KacperKub/Robot_empatyczny/Piny.txt

PC0  - Czujnik prądu 		- silnik B
PC1  - Czujnik prądu 		- silnik A

PC5  - Czujnik odległości 1     - XShut
PC13 - Czujnik odległości 2 	- XShut
PB2  - Czujnik odległości 3	- XShut
PB8  - Czujnik odległości 1-3   - VL_IRQ

PA0  - Enkoder silnika 2	- Port A ( wyjście Halla 1 )
PA1  - Enkoder silnika 2 	- Port B ( wyjście Halla 2 )
PB6  - Enkoder silnika 1	- Port A ( wyjście Halla 1 )
PB7  - Enkoder silnika 1 	- Port B ( wyjście Halla 2 )

PA6  - Mostek H			- AIN 1 
PA7  - Mostek H			- AIN 2
PB0  - Mostek H 		- BIN 2
PB1  - Mostek H			- BIN 1
PB14 - Mostek H      		- nSleep
PB13 - Mostek H			- nFault ( "1" to dobrze )

PA8  - Nucleo 			- SCL
PC9  - Nucleo			- SDA
PA9  - Nucleo 			- UART_TX
PA10 - Nucleo 			- UART_RX
