KacperKub/Robot_empatyczny/Pin_config.png

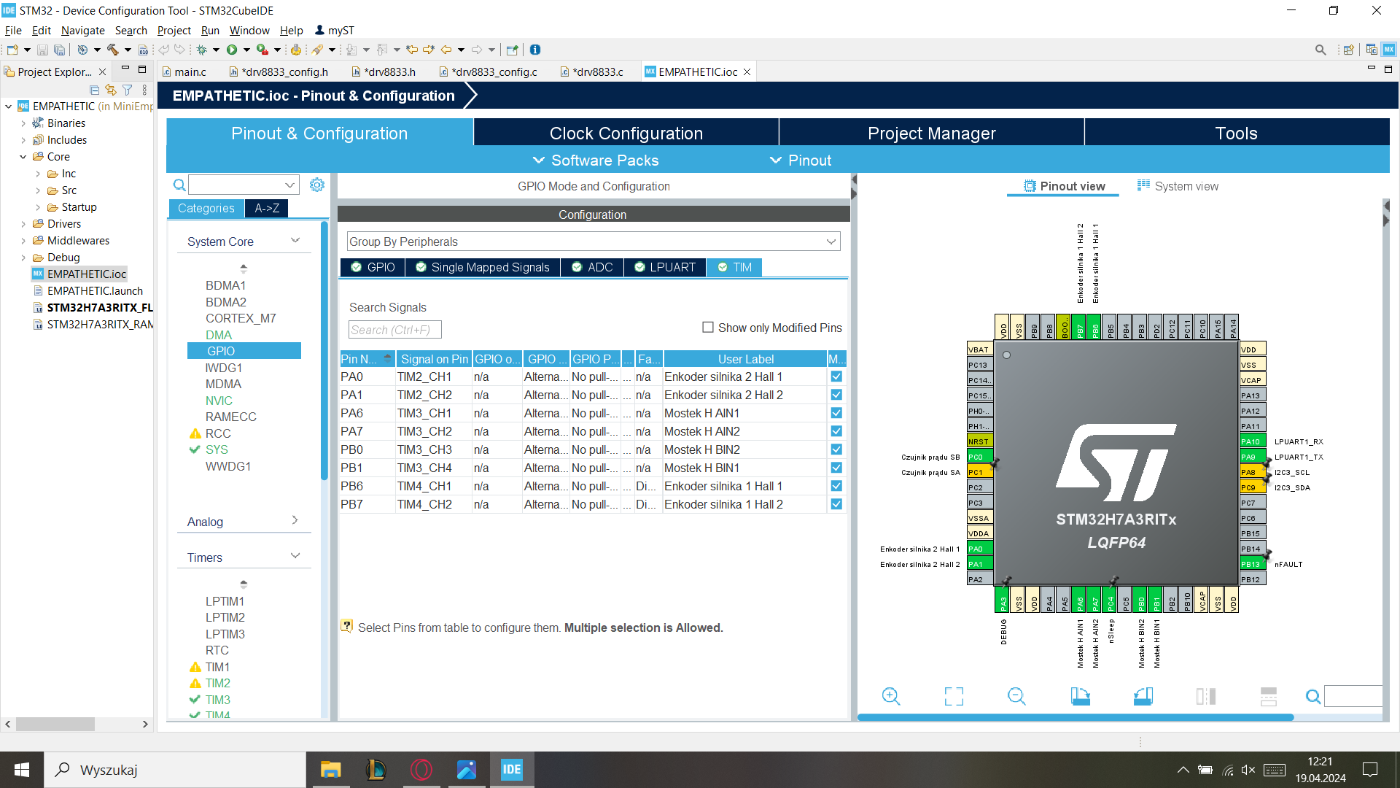
Pin_config.png
