KacperKub/Robot_empatyczny/Github_RobotUAM/kicad_workspace/3d_models/tp5100.step

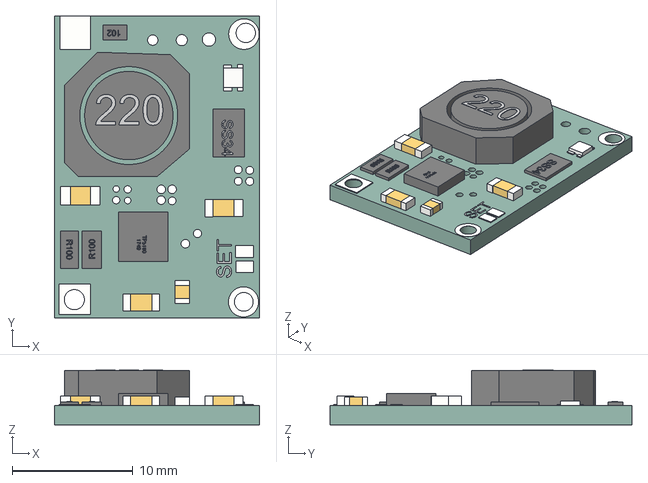
[picture p5: CAD file, 2024-04-26]
Github_RobotUAM/kicad_workspace/3d_models/tp5100.step
17.0 x 25.0 x 4.54 mm
