KacperKub/Robot_empatyczny/Github_RobotUAM/kicad_workspace/3d_models/pololu-ball-caster-with-0-375in-ball.step

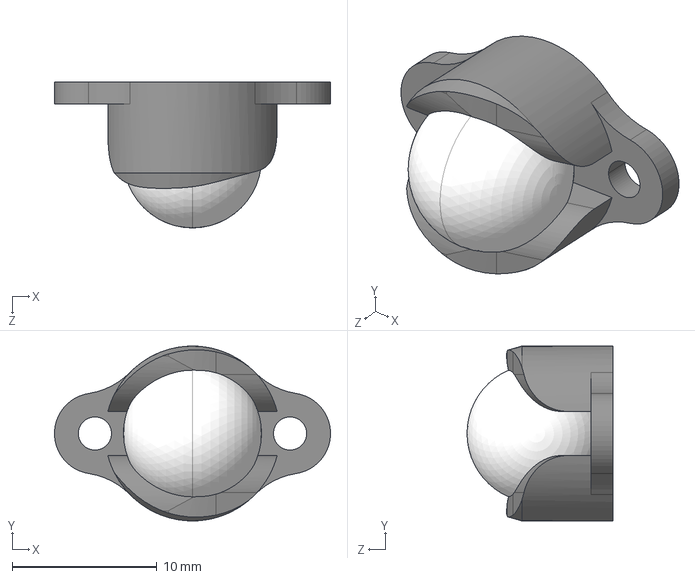
[picture p6: CAD file, 2024-04-26]
Github_RobotUAM/kicad_workspace/3d_models/pololu-ball-caster-with-0-375in-ball.step
19.0 x 12.1 x 10.1 mm
