KacperKub/Robot_empatyczny/Github_RobotUAM/kicad_workspace/3d_models/pololu-wheel-32x7mm-black.step

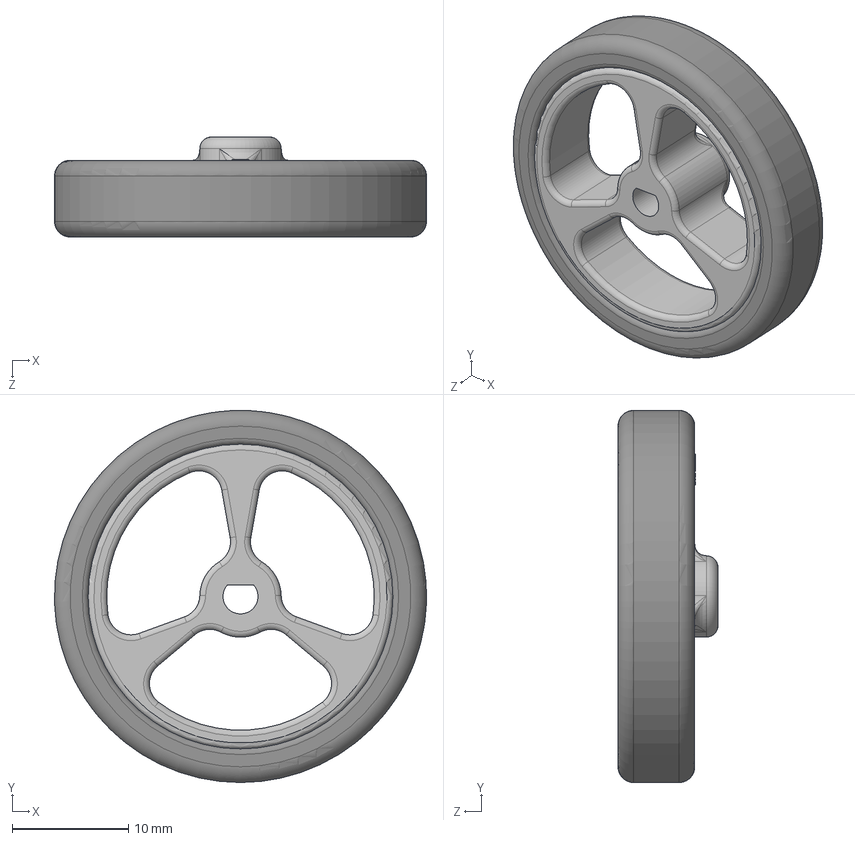
[picture p7: CAD file, 2024-04-26]
Github_RobotUAM/kicad_workspace/3d_models/pololu-wheel-32x7mm-black.step
32.0 x 32.0 x 8.60 mm
