KacperKub/Robot_empatyczny/Github_RobotUAM/kicad_workspace/3d_models/magnetic-encoder-pair-kit-for-micro-metal-gearmotors-hpcb-compatible-w1r02a.step

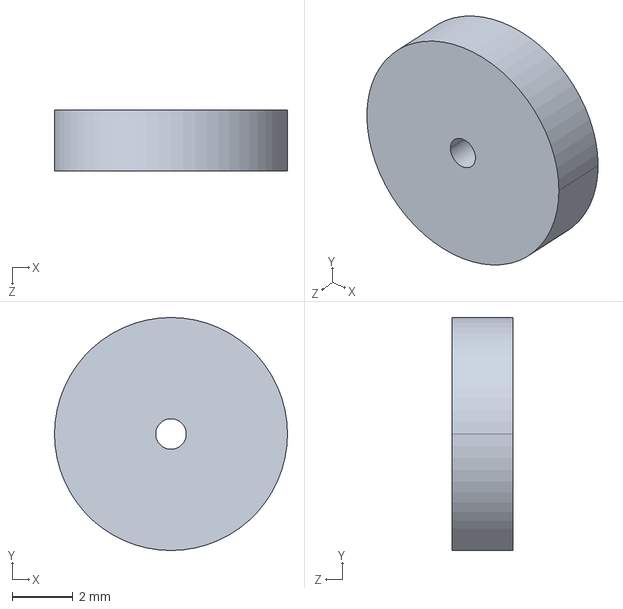
[picture p8: CAD file, 2024-04-26]
Github_RobotUAM/kicad_workspace/3d_models/magnetic-encoder-pair-kit-for-micro-metal-gearmotors-hpcb-compatible-w1r02a.step
7.65 x 7.65 x 2.00 mm
