KacperKub/Robot_empatyczny/Github_RobotUAM/kicad_workspace/3d_models/vl53l0x.stp

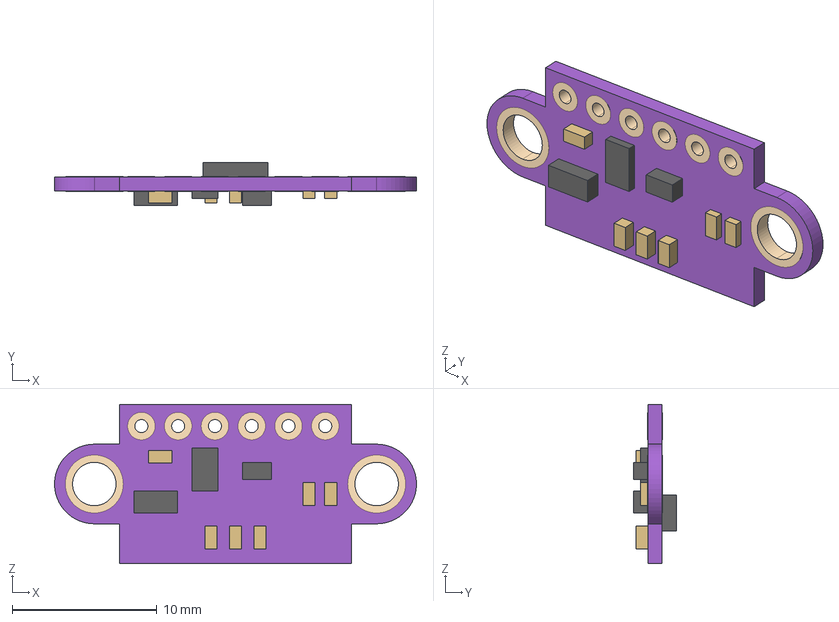
[picture p9: CAD file, 2024-04-26]
Github_RobotUAM/kicad_workspace/3d_models/vl53l0x.stp
25.0 x 3.00 x 11.0 mm
