KacperKub/Robot_empatyczny/Github_RobotUAM/kicad_workspace/3d_models/ultrasound.step

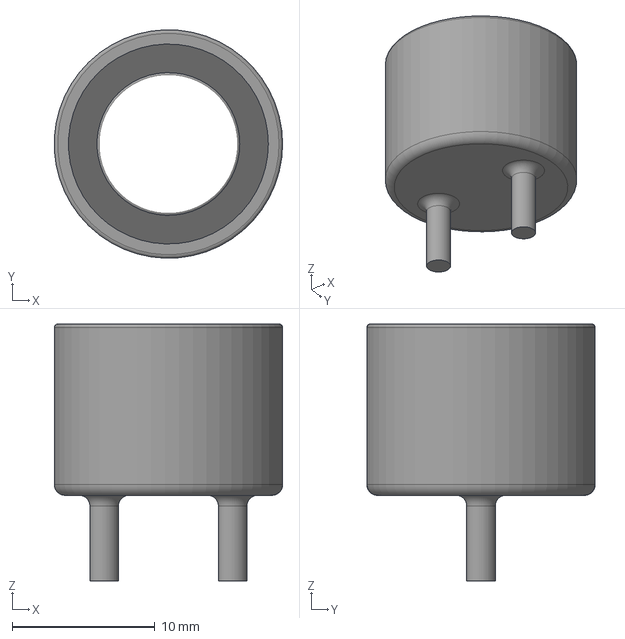
[picture p10: CAD file, 2024-04-26]
Github_RobotUAM/kicad_workspace/3d_models/ultrasound.step
16.0 x 16.0 x 18.0 mm
