KacperKub/Robot_empatyczny/Github_RobotUAM/kicad_workspace/3d_models/pololu-step-up-step-down-voltage-regulator-s7v8fx.step

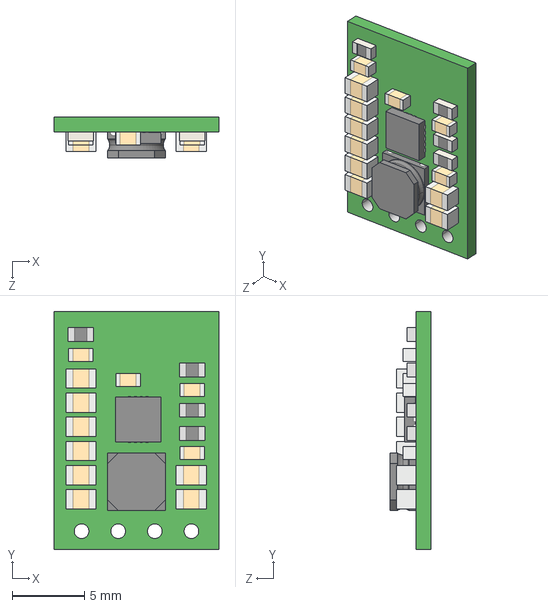
[picture p11: CAD file, 2024-04-26]
Github_RobotUAM/kicad_workspace/3d_models/pololu-step-up-step-down-voltage-regulator-s7v8fx.step
11.4 x 16.5 x 2.82 mm
