KacperKub/Robot_empatyczny/Github_RobotUAM/kicad_workspace/3d_models/magnetic-encoder-pair-kit-for-micro-metal-gearmotors-hpcb-compatible-enc03b.step

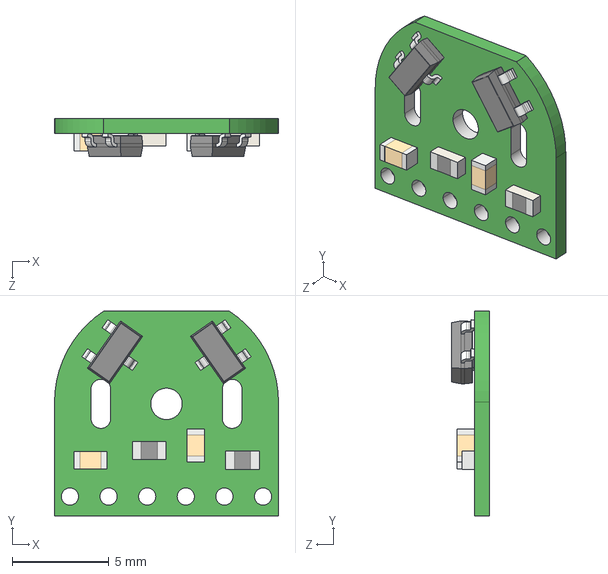
[picture p12: CAD file, 2024-04-26]
Github_RobotUAM/kicad_workspace/3d_models/magnetic-encoder-pair-kit-for-micro-metal-gearmotors-hpcb-compatible-enc03b.step
11.6 x 10.6 x 1.99 mm
