KacperKub/Robot_empatyczny/Github_RobotUAM/kicad_workspace/3d_models/ark_conn.step

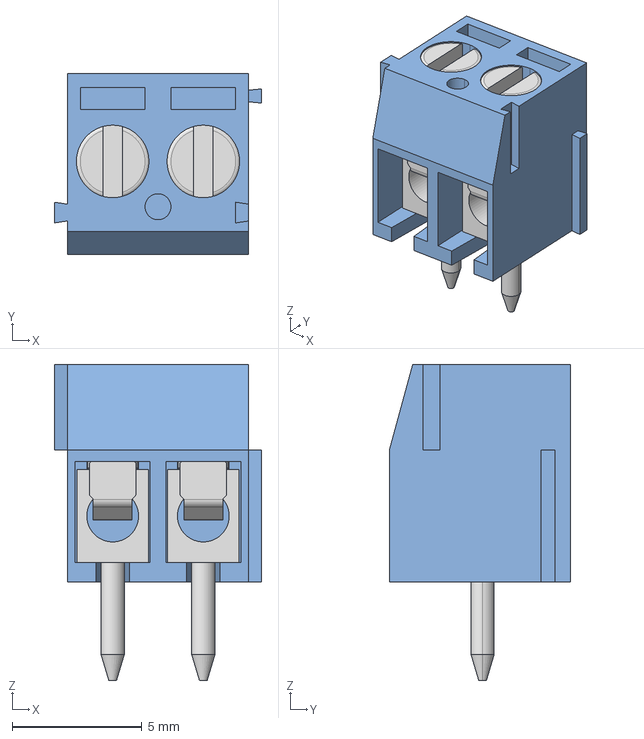
[picture p13: CAD file, 2024-04-26]
Github_RobotUAM/kicad_workspace/3d_models/ark_conn.step
8.00 x 7.00 x 12.2 mm
