KacperKub/Robot_empatyczny/Github_RobotUAM/kicad_workspace/3d_models/BQ24250RGER.stp

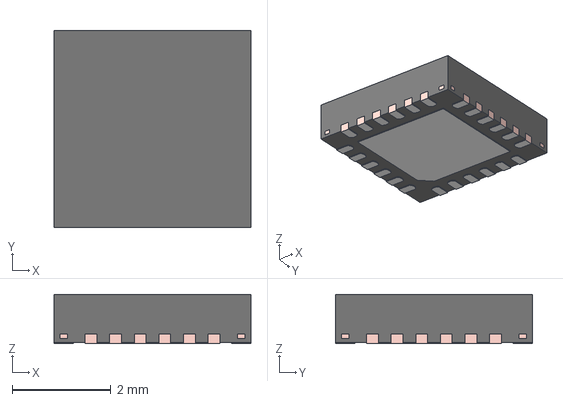
[picture p14: CAD file, 2024-04-26]
Github_RobotUAM/kicad_workspace/3d_models/BQ24250RGER.stp
4.00 x 4.00 x 1.00 mm
FRAME
