KacperKub/Robot_empatyczny/Github_RobotUAM/kicad_workspace/3d_models/INR18650-35E-Samsung.STEP

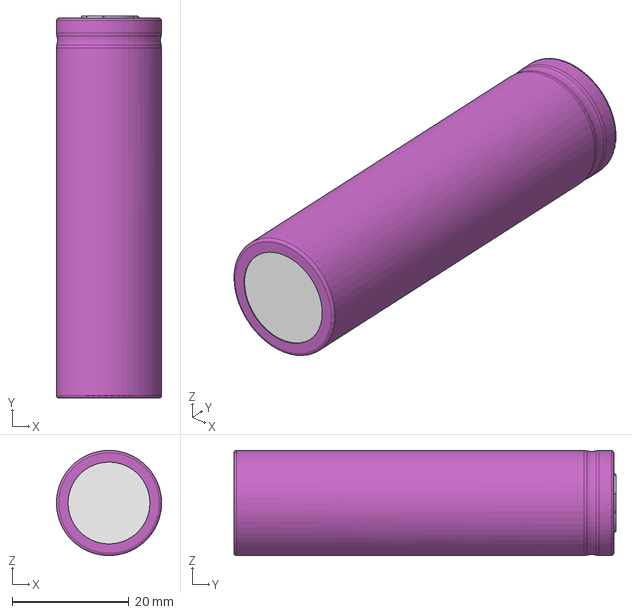
[picture p15: CAD file, 2024-04-26]
Github_RobotUAM/kicad_workspace/3d_models/INR18650-35E-Samsung.STEP
18.0 x 65.4 x 18.0 mm
