KacperKub/Robot_empatyczny/(list of files, cad)

Other CAD files:
Github_RobotUAM/kicad_workspace/bottom/pcb_shape/shape.FCStd
Github_RobotUAM/kicad_workspace/bottom/pcb_shape/shape_with_mount_holes.FCStd
Github_RobotUAM/kicad_workspace/bottom/pcb_shape/shape.dxf
