KacperKub/Robot_empatyczny/Github_RobotUAM/kicad_workspace/bottom/bottom.kicad_pcb

## KiCad design Github_RobotUAM/kicad_workspace/bottom/bottom.kicad_pcb (2024-04-26)

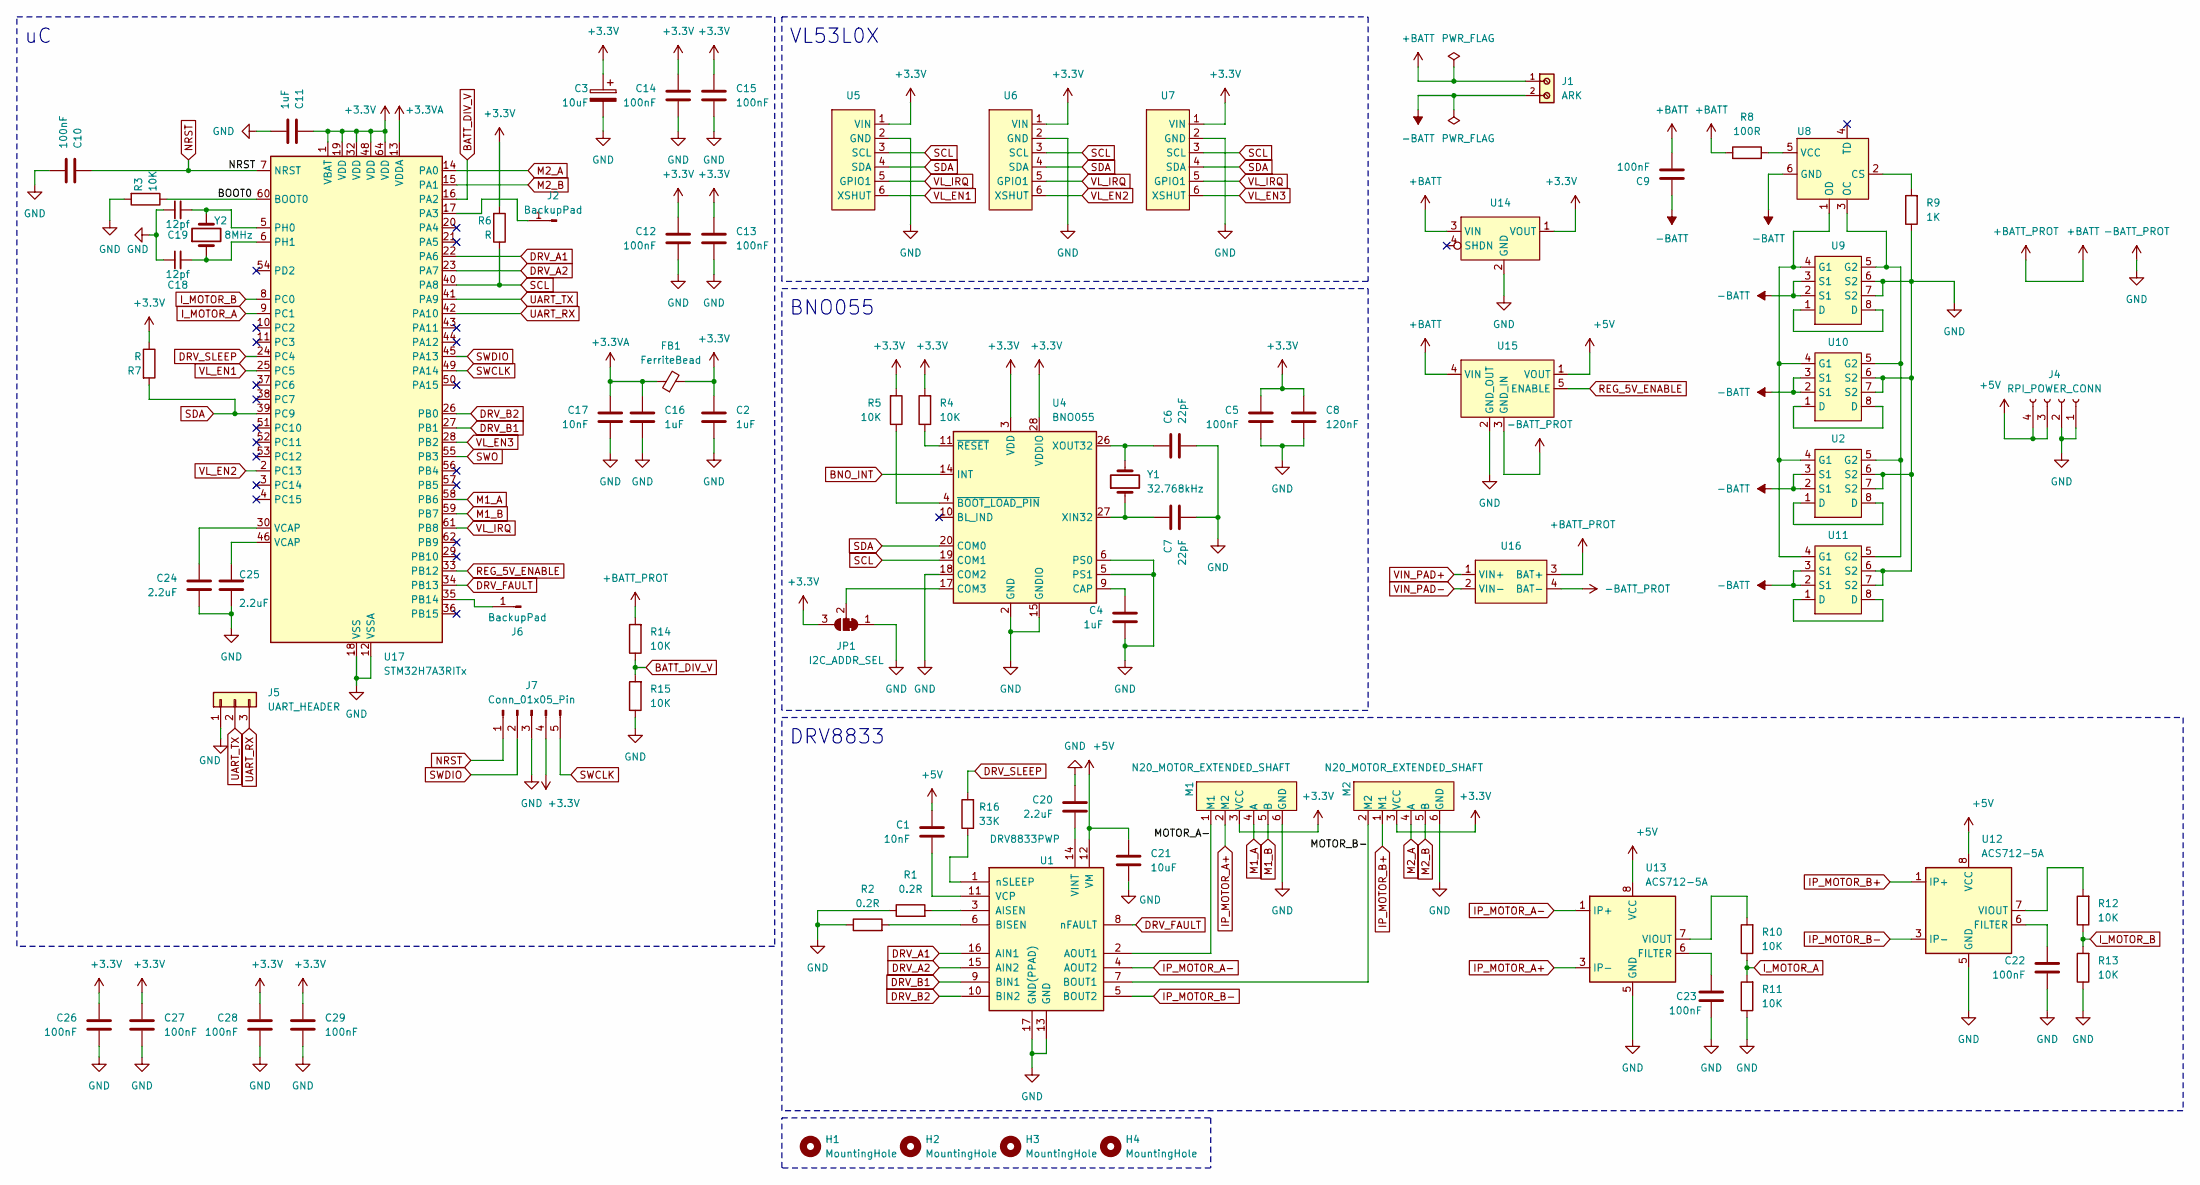
[picture p16: schematic bottom.kicad_sch]

Parts:
C1, C17: 10nF; C_0805_2012Metric
C2, C4, C11, C16: 1uF; C_0805_2012Metric
C3: 10uF; CP_Elec_4x3
C5, C9, C10, C12, C13, C14, C15, C22, C23, C26, C27, C28, C29: 100nF; C_0805_2012Metric
C6, C7: 22pF; C_0805_2012Metric
C8: 120nF; C_0805_2012Metric
C18, C19: 12pf; C_0805_2012Metric
C20, C24, C25: 2.2uF; C_0805_2012Metric
C21: 10uF; C_0805_2012Metric
FB1: FerriteBead; L_0805_2012Metric
H1, H2, H3, H4: MountingHole
J1: ARK; 691103110002; PART-NUMBER 691103110002
J2, J6: BackupPad; SolderWirePad_1x01_SMD_1x2mm
J4: RPI_POWER_CONN; JST_XH_B4B-XH-A_1x04_P2.50mm_Vertical
J5: UART_HEADER; PinHeader_1x03_P2.54mm_Vertical
J7: Conn_01x05_Pin; Harwin_M20-89005xx_1x05_P2.54mm_Horizontal
JP1: I2C_ADDR_SEL; SolderJumper-3_P1.3mm_Bridged12_Pad1.0x1.5mm_NumberLabels
M1, M2: N20_MOTOR_EXTENDED_SHAFT; N20_EXTENDED_SHAFT
R1, R2: 0.2R; R_0805_2012Metric
R3, R4, R5, R10, R11, R12, R13, R14, R15: 10K; R_0805_2012Metric
R6, R7: R; R_0805_2012Metric
R8: 100R; R_0805_2012Metric
R9: 1K; R_0805_2012Metric
R16: 33K; R_0805_2012Metric
U1: DRV8833PWP; TSSOP-16-1EP_4.4x5mm_P0.65mm_EP3x3mm_ThermalVias
U2, U9, U10, U11: TSSOP-8_4.4x3mm_P0.65mm
U4: BNO055; LGA-28_5.2x3.8mm_P0.5mm
U5, U6, U7: VL53L0X
U8: SOT-23-6
U12, U13: ACS712-5A; SOIC-8_3.9x4.9mm_P1.27mm
U14: S7V8F3_vertical
U15: U3V70F5
U16: TP5100
U17: STM32H7A3RITx; LQFP-64_10x10mm_P0.5mm
Y1: 32.768kHz; Crystal_SMD_MicroCrystal_CM9V-T1A-2Pin_1.6x1.0mm
Y2: 8MHz; Crystal_SMD_MicroCrystal_CM9V-T1A-2Pin_1.6x1.0mm

Connections:
+3.3V: C2.1, C3.1, C5.1, C8.1, C11.1, C12.1, C13.1, C14.1, C15.1, C26.1, C27.1, C28.1, C29.1, FB1.2, J7.4, JP1.3 (B), M1.3 (VCC), M2.3 (VCC), R4.2, R5.2, R6.2, R7.1, U4.3 (VDD), U4.28 (VDDIO), U5.1 (VIN), U6.1 (VIN), U7.1 (VIN), U14.1 (VOUT), U17.1 (VBAT), U17.19 (VDD), U17.32 (VDD), U17.48 (VDD), U17.64 (VDD)
+3.3VA: C16.1, C17.1, FB1.1, U17.13 (VDDA)
+5V: C1.1, C21.1, J4.3, J4.4, U1.12 (VM), U12.8 (VCC), U13.8 (VCC), U15.1 (VOUT)
+BATT: C9.2, J1.1, R8.1, R14.2, U14.3 (VIN), U15.4 (VIN), U16.3 (BAT+)
-BATT: C9.1, J1.2, U2.2 (S1), U2.3 (S1), U8.6 (GND), U9.2 (S1), U9.3 (S1), U10.2 (S1), U10.3 (S1), U11.2 (S1), U11.3 (S1)
-BATT_PROT: C2.2, C3.2, C4.2, C5.2, C6.2, C7.2, C8.2, C10.2, C11.2, C12.2, C13.2, C14.2, C15.2, C16.2, C17.2, C18.1, C19.1, C20.1, C21.2, C22.2, C23.2, C24.2, C25.2, C26.2, C27.2, C28.2, C29.2, J4.1, J4.2, J5.1, J7.3, JP1.1 (A), M1.6 (GND), M2.6 (GND), R1.1, R2.1, R3.2, R9.1, R11.1, R13.1, R15.1, U1.13 (GND), U1.17 (GND(PPAD)), U2.6 (S2), U2.7 (S2), U4.2 (GND), U4.5 (PS1), U4.6 (PS0), U4.15 (GNDIO), U4.16 (GNDIO), U4.18 (COM2), U4.25 (GNDIO), U5.2 (GND), U6.2 (GND), U7.2 (GND), U9.6 (S2), U9.7 (S2), U10.6 (S2), U10.7 (S2), U11.6 (S2), U11.7 (S2), U12.5 (GND), U13.5 (GND), U14.2 (GND), U15.2 (GND_OUT), U15.3 (GND_IN), U16.4 (BAT-), U17.12 (VSSA), U17.18 (VSS), U17.31 (VSS), U17.47 (VSS), U17.63 (VSS)
/BOOT0: R3.1, U17.60 (BOOT0)
/MOTOR_A-: M1.1 (M1), U1.2 (AOUT1)
BATT_DIV_V: R14.1, R15.2, U17.16 (PA2)
BNO_INT: U4.14 (INT)
DRV_A1: U1.16 (AIN1), U17.22 (PA6)
DRV_A2: U1.15 (AIN2), U17.23 (PA7)
DRV_B1: U1.9 (BIN1), U17.27 (PB1)
DRV_B2: U1.10 (BIN2), U17.26 (PB0)
DRV_FAULT: U1.8 (nFAULT), U17.34 (PB13)
DRV_SLEEP: R16.2, U17.24 (PC4)
IP_MOTOR_A+: M1.2 (M2), U13.3 (IP-), U13.4 (IP-)
IP_MOTOR_A-: U1.4 (AOUT2), U13.1 (IP+), U13.2 (IP+)
IP_MOTOR_B-: U1.5 (BOUT2), U12.3 (IP-), U12.4 (IP-)
I_MOTOR_A: R10.1, R11.2, U17.9 (PC1)
I_MOTOR_B: R12.1, R13.2, U17.8 (PC0)
M1_A: M1.4 (A), U17.58 (PB6)
M1_B: M1.5 (B), U17.59 (PB7)
M2_A: M2.4 (A), U17.14 (PA0)
M2_B: M2.5 (B), U17.15 (PA1)
NRST: C10.1, J7.1, U17.7 (NRST)
unnamed: C24.1, U17.30 (VCAP)
unnamed: C25.1, U17.46 (VCAP)
unnamed: J2.1, U17.17 (PA3)
unnamed: J6.1, U17.35 (PB14)
unnamed: JP1.2 (C), U4.17 (COM3)
unnamed: R1.2, U1.3 (AISEN)
unnamed: R2.2, U1.6 (BISEN)
unnamed: C1.2, U1.11 (VCP)
unnamed: C20.2, U1.14 (VINT)
unnamed: R16.1, U1.1 (nSLEEP)
unnamed: U2.1 (D), U2.8 (D)
unnamed: C4.1, U4.9 (CAP)
unnamed: C7.1, U4.27 (XIN32), Y1.1
unnamed: C6.1, U4.26 (XOUT32), Y1.2
unnamed: R5.1, U4.4 (~BOOT_LOAD_PIN)
unnamed: R4.1, U4.11 (~RESET)
unnamed: R9.2, U8.2 (CS)
unnamed: R8.2, U8.5 (VCC)
unnamed: U9.1 (D), U9.8 (D)
unnamed: U10.1 (D), U10.8 (D)
unnamed: U2.4 (G1), U8.1 (OD), U9.4 (G1), U10.4 (G1), U11.4 (G1)
unnamed: U2.5 (G2), U8.3 (OC), U9.5 (G2), U10.5 (G2), U11.5 (G2)
unnamed: U11.1 (D), U11.8 (D)
unnamed: C22.1, U12.6 (FILTER)
unnamed: R12.2, U12.7 (VIOUT)
unnamed: C23.1, U13.6 (FILTER)
unnamed: R10.2, U13.7 (VIOUT)
unnamed: C19.2, U17.5 (PH0), Y2.2
unnamed: C18.2, U17.6 (PH1), Y2.1
REG_5V_ENABLE: U15.5 (ENABLE), U17.33 (PB12)
SCL: R6.1, U4.19 (COM1), U5.3 (SCL), U6.3 (SCL), U7.3 (SCL), U17.40 (PA8)
SDA: R7.2, U4.20 (COM0), U5.4 (SDA), U6.4 (SDA), U7.4 (SDA), U17.39 (PC9)
SWCLK: J7.5, U17.49 (PA14)
SWDIO: J7.2, U17.45 (PA13)
SWO: U17.55 (PB3)
UART_RX: J5.3, U17.42 (PA10)
UART_TX: J5.2, U17.41 (PA9)
VIN_PAD+: U16.1 (VIN+)
VIN_PAD-: U16.2 (VIN-)
VL_EN1: U5.6 (XSHUT), U17.25 (PC5)
VL_EN2: U6.6 (XSHUT), U17.2 (PC13)
VL_EN3: U7.6 (XSHUT), U17.28 (PB2)
VL_IRQ: U5.5 (GPIO1), U6.5 (GPIO1), U7.5 (GPIO1), U17.61 (PB8)

Notes on the sheet:
DRV8833
VL53L0X
BNO055

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
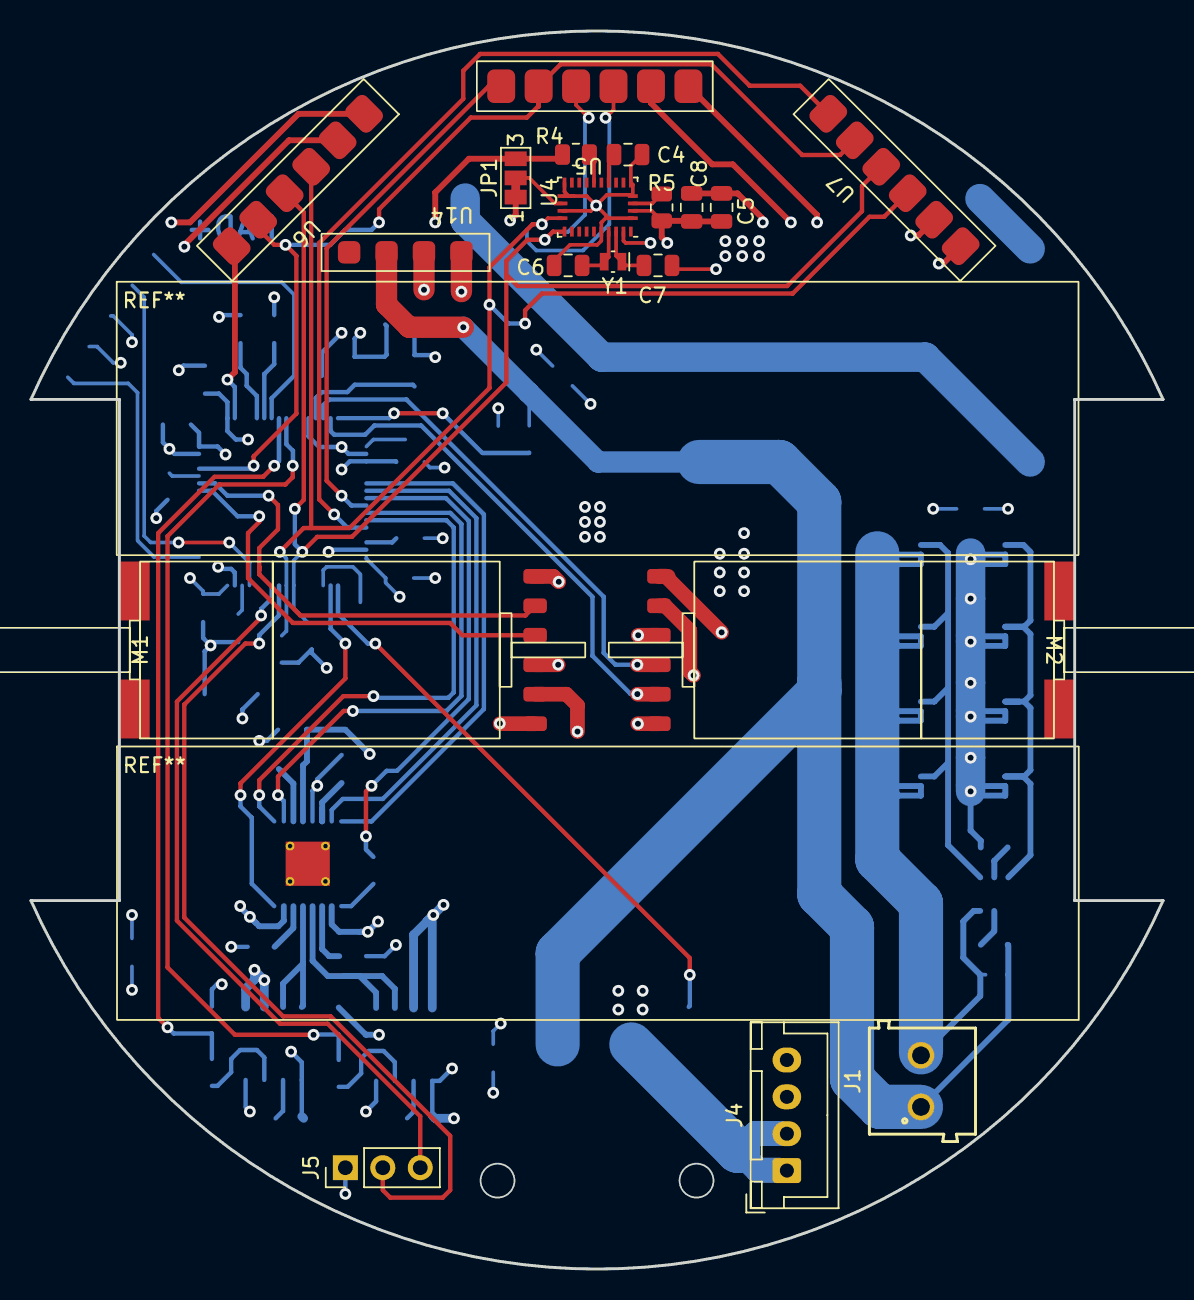
[picture p17: board bottom.kicad_pcb from above]

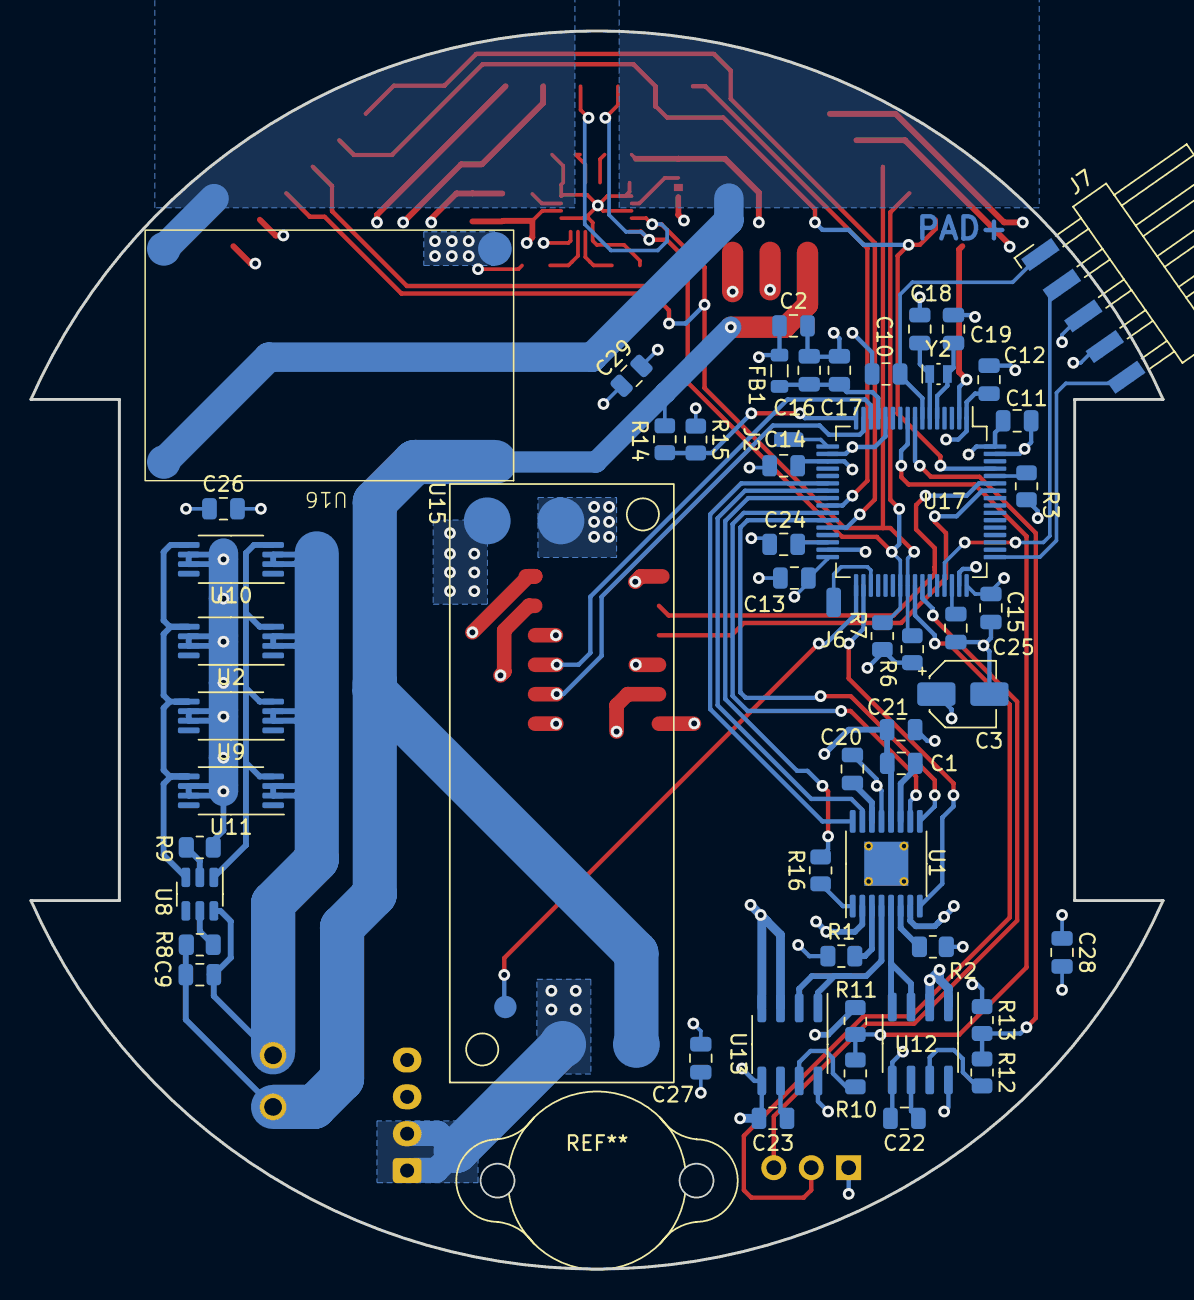
[picture p18: board bottom.kicad_pcb from below]

Board: 4 copper layers, 76.8 x 84.0 mm, 73 parts (54 on the bottom side), 67 nets.
