KacperKub/Robot_empatyczny/Oprogramowanie_main/Core/Src/main.c

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
/* Includes ------------------------------------------------------------------*/
#include "main.h"
#include "adc.h"
#include "dma.h"
#include "usart.h"
#include "tim.h"
#include "gpio.h"

/* USER CODE BEGIN Includes */
#include <stdio.h>
#include <stdlib.h>
#include <string.h>

#include "arm_math.h"
#include "FIR/fir_coefs.h"

#include "drv8833_config.h"


/* USER CODE END Includes */

/* USER CODE BEGIN PD */
#define LEFT 350
#define RIGHT 275

#define OVERSAMPLING 16
#define ADC_RES 16
/* USER CODE END PD */


/* USER CODE BEGIN PV */
volatile uint32_t adc_buffer;
float adc_value;

arm_fir_instance_f32 fir_instance;
float32_t fir_in, fir_out, fir_state[FIR_LENGTH];

unsigned char rxData[32];
uint16_t rxDataSize;


float duty = 0.0f;
int16_t counter = 0;
/* USER CODE END PV */

void SystemClock_Config(void);
/* USER CODE BEGIN 0 */

//void HAL_ADC_ConvCpltCallback(ADC_HandleTypeDef *_hadc) {
//  adc_value = adc_buffer * 3.3f / ((1 << ADC_RES) - 1) / OVERSAMPLING * 2;
//
//  HAL_GPIO_TogglePin(DEBUG_GPIO_Port, DEBUG_Pin);
//
//  fir_in = (float32_t) adc_value;
//  arm_fir_f32(&fir_instance, &fir_in, &fir_out, 1);
//}
//
//void motor_left_forward(short unsigned int cmp) {
//  __HAL_TIM_SET_COMPARE(&htim3, TIM_CHANNEL_1, cmp);
//  __HAL_TIM_SET_COMPARE(&htim3, TIM_CHANNEL_2, 0);
//}
//
//void motor_right_forward(short unsigned int cmp) {
//  __HAL_TIM_SET_COMPARE(&htim3, TIM_CHANNEL_3, cmp);
//  __HAL_TIM_SET_COMPARE(&htim3, TIM_CHANNEL_4, 0);
//}
//
//void motor_left_backward(short unsigned int cmp) {
//  __HAL_TIM_SET_COMPARE(&htim3, TIM_CHANNEL_1, 0);
//  __HAL_TIM_SET_COMPARE(&htim3, TIM_CHANNEL_2, cmp);
//}
//
//void motor_right_backward(short unsigned int cmp) {
//  __HAL_TIM_SET_COMPARE(&htim3, TIM_CHANNEL_3, 0);
//  __HAL_TIM_SET_COMPARE(&htim3, TIM_CHANNEL_4, cmp);
//}
//
//void motor_left_stop(void) {
//  __HAL_TIM_SET_COMPARE(&htim3, TIM_CHANNEL_1, 0);
//  __HAL_TIM_SET_COMPARE(&htim3, TIM_CHANNEL_2, 0);
//}
//
//void motor_right_stop(void) {
//  __HAL_TIM_SET_COMPARE(&htim3, TIM_CHANNEL_3, 0);
//  __HAL_TIM_SET_COMPARE(&htim3, TIM_CHANNEL_4, 0);
//}

/**
  * @brief  Rx Transfer completed callback.
  * @param  huart UART handle.
  * @retval None
  */
//void HAL_UART_RxCpltCallback(UART_HandleTypeDef *huart)
//{
//  if(huart == &hlpuart1)
//  {
//    int left = 0, right = 0;
//    sscanf((char*)rxData, "%d,%d", &left, &right);
//
//    motor_left_forward(left);
//    motor_right_forward(right);
//
//    HAL_UART_Receive_IT(&hlpuart1, rxData, rxDataSize);
//  }
//}

/* USER CODE END 0 */

/**
  * @brief  The application entry point.
  * @retval int
  */
int main(void)
{

  /* USER CODE BEGIN 1 */
//  arm_fir_init_f32(&fir_instance, FIR_LENGTH, fir_coefficients, fir_state, 1);
  /* USER CODE END 1 */

  /* MCU Configuration--------------------------------------------------------*/

  /* Reset of all peripherals, Initializes the Flash interface and the Systick. */
  HAL_Init();

  /* Configure the system clock */
  SystemClock_Config();

  /* Initialize all configured peripherals */
  MX_GPIO_Init();
  MX_DMA_Init();
  MX_LPUART1_UART_Init();
  MX_TIM3_Init();
  MX_TIM4_Init();
  MX_ADC2_Init();
  MX_TIM2_Init();
  MX_TIM15_Init();
  /* USER CODE BEGIN 2 */


  drv8833_init(&drv8833);
  drv8833_start(&drv8833);


//  HAL_ADCEx_Calibration_Start(&hadc2, ADC_CALIB_OFFSET,
//  ADC_DIFFERENTIAL_ENDED);
  HAL_TIM_Encoder_Start(&htim2, TIM_CHANNEL_ALL);
//  HAL_TIM_Encoder_Start(&htim4, TIM_CHANNEL_ALL);
//
//  HAL_TIM_PWM_Start(&htim3, TIM_CHANNEL_1);
//  HAL_TIM_PWM_Start(&htim3, TIM_CHANNEL_2);
//  HAL_TIM_PWM_Start(&htim3, TIM_CHANNEL_3);
//  HAL_TIM_PWM_Start(&htim3, TIM_CHANNEL_4);
//
//  HAL_UART_Transmit(&hlpuart1, (uint8_t*) "Starting\r\n", 10, HAL_MAX_DELAY);
//  HAL_TIM_Base_Start(&htim15);
  //HAL_ADC_Start_DMA(&hadc2, (uint32_t*) &adc_buffer, 1);
  /* USER CODE END 2 */

  /* Infinite loop */
  /* USER CODE BEGIN WHILE */
//  HAL_GPIO_WritePin(nSleep_GPIO_Port, nSleep_Pin, GPIO_PIN_SET);
//
//  uint32_t line_num = 0;
//
//  uint32_t uart_report = HAL_GetTick();
//
//  rxDataSize = strlen("+000,+000");
//  HAL_UART_Receive_IT(&hlpuart1, rxData, rxDataSize);

  //while (1)
  //  ;

  while (1) {
    drv8833_speed_change(&drv8833, A_B, duty);

    counter = __HAL_TIM_GET_COUNTER(&htim2);

    /* USER CODE END WHILE */

    /* USER CODE BEGIN 3 */
//    uint8_t data[256];
//    uint32_t counter2 = __HAL_TIM_GET_COUNTER(&htim2);
//    uint32_t counter4 = __HAL_TIM_GET_COUNTER(&htim4);
//
//    uint8_t value = (
//        HAL_GPIO_ReadPin(nFAULT_GPIO_Port, nFAULT_Pin) == GPIO_PIN_SET ? 1 : 0);
//
//    if (HAL_GetTick() - uart_report > 1000) {
//      uint8_t len =
//          sprintf((char*) data,
//              "{%ld}: Hello World! Encoder2: %ld, Encoder4: %ld, nFault: %d, adc_value: %f, raw_adc: %ld\r\n",
//              line_num++, counter2, counter4, value, adc_value, adc_buffer);
//      HAL_UART_Transmit(&hlpuart1, data, len, HAL_MAX_DELAY);
//
//      uart_report = HAL_GetTick();
//    }

  }
  /* USER CODE END 3 */
}

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
