KacperKub/Robot_empatyczny/Github_RobotUAM/code/STM32/EMPATHETIC/EMPATHETIC.ioc

Mcu.UserName=STM32H7A3RITx
PA0.Signal=S_TIM2_CH1_ETR
PA1.Signal=S_TIM2_CH2
PA10.Signal=LPUART1_RX
PA3.GPIO_Label=DEBUG
PA3.Signal=GPIO_Output
PA6.Signal=S_TIM3_CH1
PA7.Signal=S_TIM3_CH2
PA9.Signal=LPUART1_TX
PB0.Signal=S_TIM3_CH3
PB1.Signal=S_TIM3_CH4
PB13.GPIO_Label=nFAULT
PB13.Signal=GPIO_Input
PB14.GPIO_Label=nSleep
PB14.Signal=GPIO_Output
PB6.Signal=S_TIM4_CH1
PB7.Signal=S_TIM4_CH2
PC0.Signal=ADCx_INP10
