KacperKub/Robot_empatyczny/Oprogramowanie_main/Core/Inc/drv8833_config.h

/*
 * drv8848_config.h
 *
 *  Created on: Jan 5, 2024
 *      Author: Kacper
 */

#ifndef INC_DRV8833_CONFIG_H_
#define INC_DRV8833_CONFIG_H_

#include <drv8833.h>

extern DRV8833_TypeDef drv8833;

#endif /* INC_DRV8833_CONFIG_H_ */
