KacperKub/Robot_empatyczny/Oprogramowanie_main/Core/Inc/optic_enc_config.h

/**
  ******************************************************************************
  * @file		: optic_enc_config.h
  * @author  	: AW		Adrian.Wojcik@put.poznan.pl
  * @version 	: 1.0.0
  * @date    	: 18 May 2023
  * @brief   	: TODO
  *
  ******************************************************************************
  */

#ifndef INC_OPTIC_ENC_CONFIG_H_
#define INC_OPTIC_ENC_CONFIG_H_

/* Public includes -----------------------------------------------------------*/

#include "optic_enc.h"

/* Public typedef ------------------------------------------------------------*/

/* Public define -------------------------------------------------------------*/

/* Public macro --------------------------------------------------------------*/

/* Public variables ----------------------------------------------------------*/
extern OPTIC_ENC_TypeDef enc1;
/* Public function prototypes ------------------------------------------------*/

#endif /**/
