KacperKub/Robot_empatyczny/(notices)

Notices in the files:
Github_RobotUAM/code/STM32/L152_ADC/Core/Inc/main.h:
Copyright (c) 2024 STMicroelectronics.
All rights reserved.
This software is licensed under terms that can be found in the LICENSE file
